jpwolfe31/8050A-Continuity-Tone-and-LED-Display/README.md

# 8050A-Continuity-Tone-and-LED-Display
Fluke 8050A Multimeter Modifications to Add Continuity Tone and LED Display

Added complete schematic and PCBs created with EasyEDA.  See the description for detailed build information made easier with the new PCBs.  Please let me know if you would like the EasyEDA project file for modifiicaitons.  Also, happy to answer any questions.



PCBs installed
