jpwolfe31/8050A-Continuity-Tone-and-LED-Display/Updated Schematic and PCBs/PCBs installed.JPG

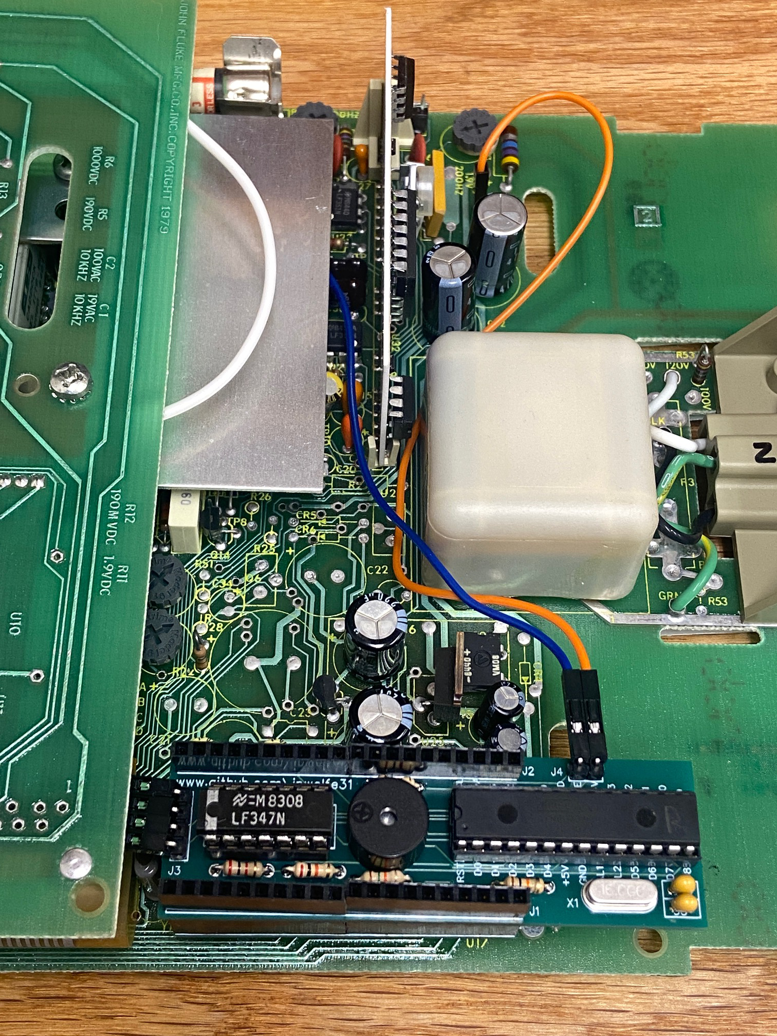
Updated Schematic and PCBs/PCBs installed.JPG
