jpwolfe31/8050A-Continuity-Tone-and-LED-Display/Updated Schematic and PCBs/8050A Carrier Board Schematic 6-12-2026.pdf

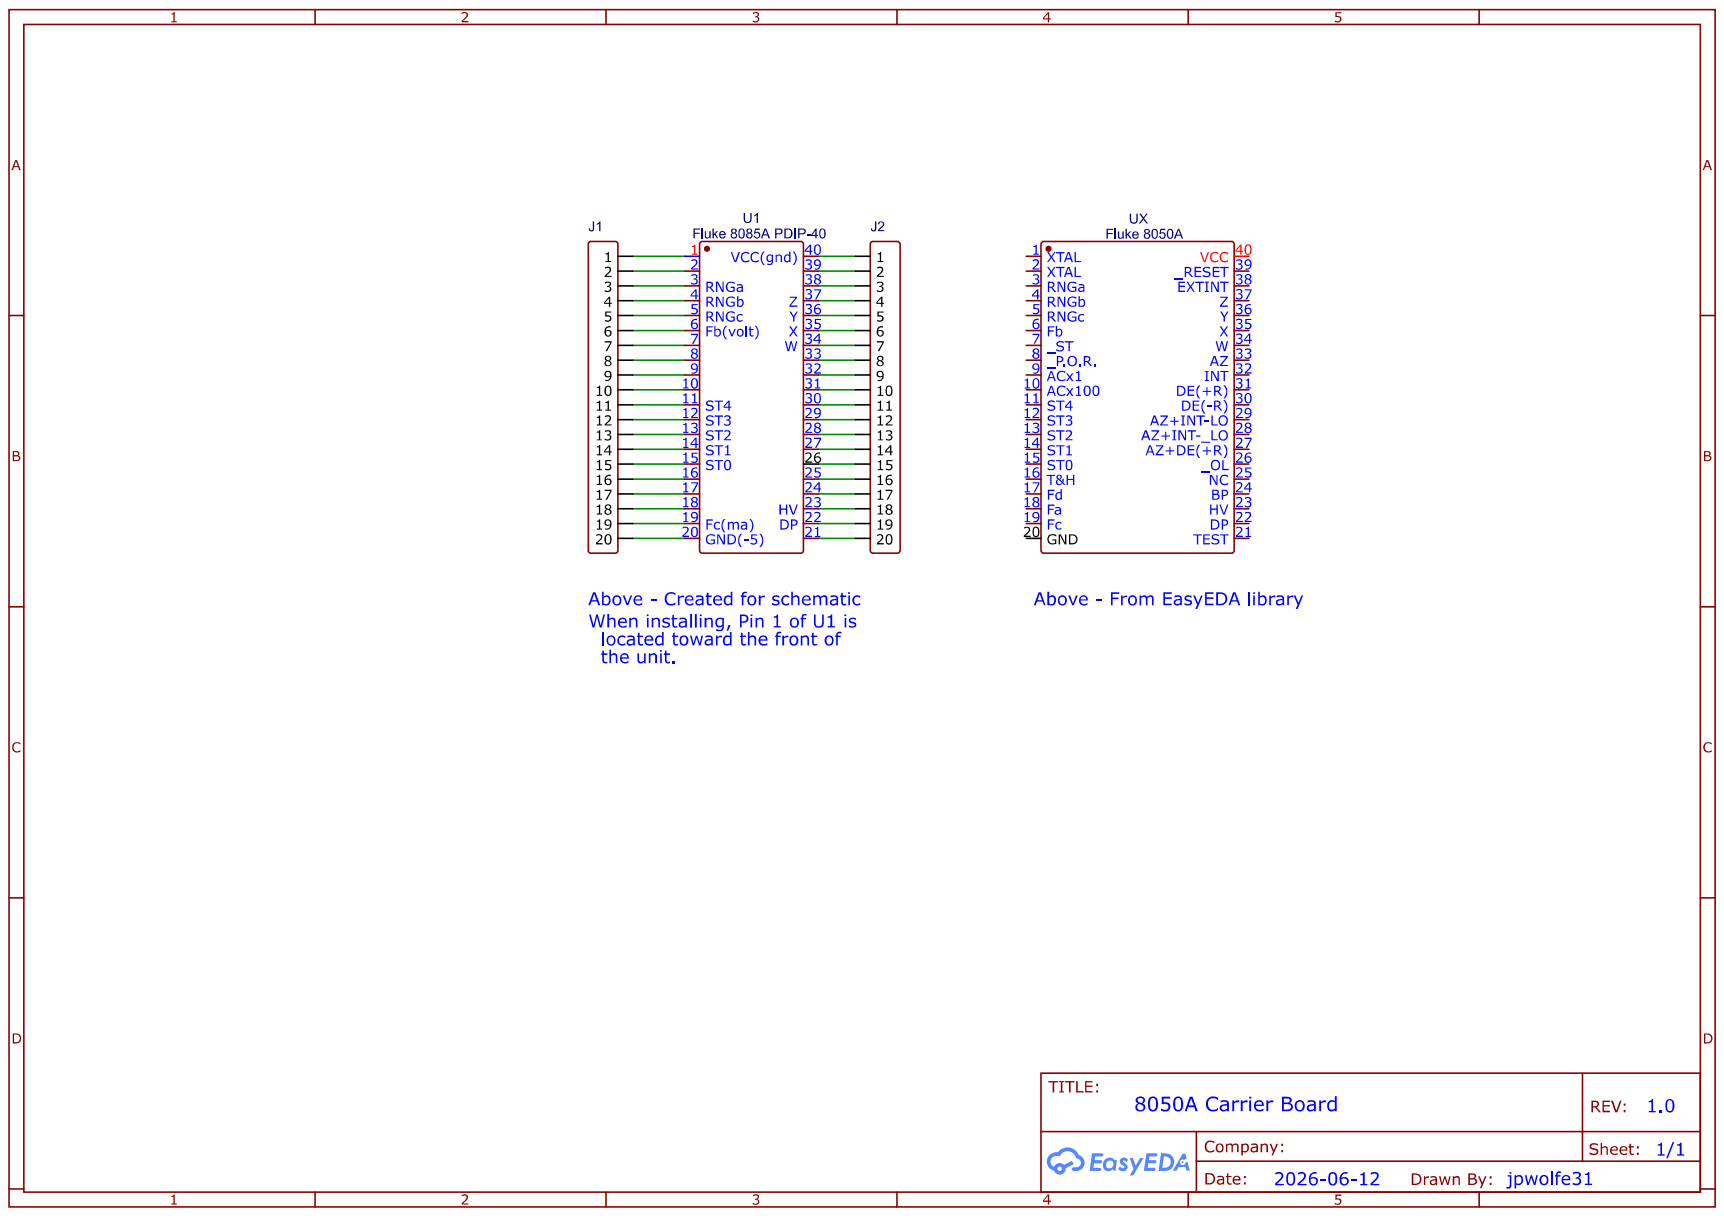
[picture p27: page 1]
