jpwolfe31/8050A-Continuity-Tone-and-LED-Display/Updated Schematic and PCBs/8050A LED and Continuity Schematic 6-12-2026.pdf

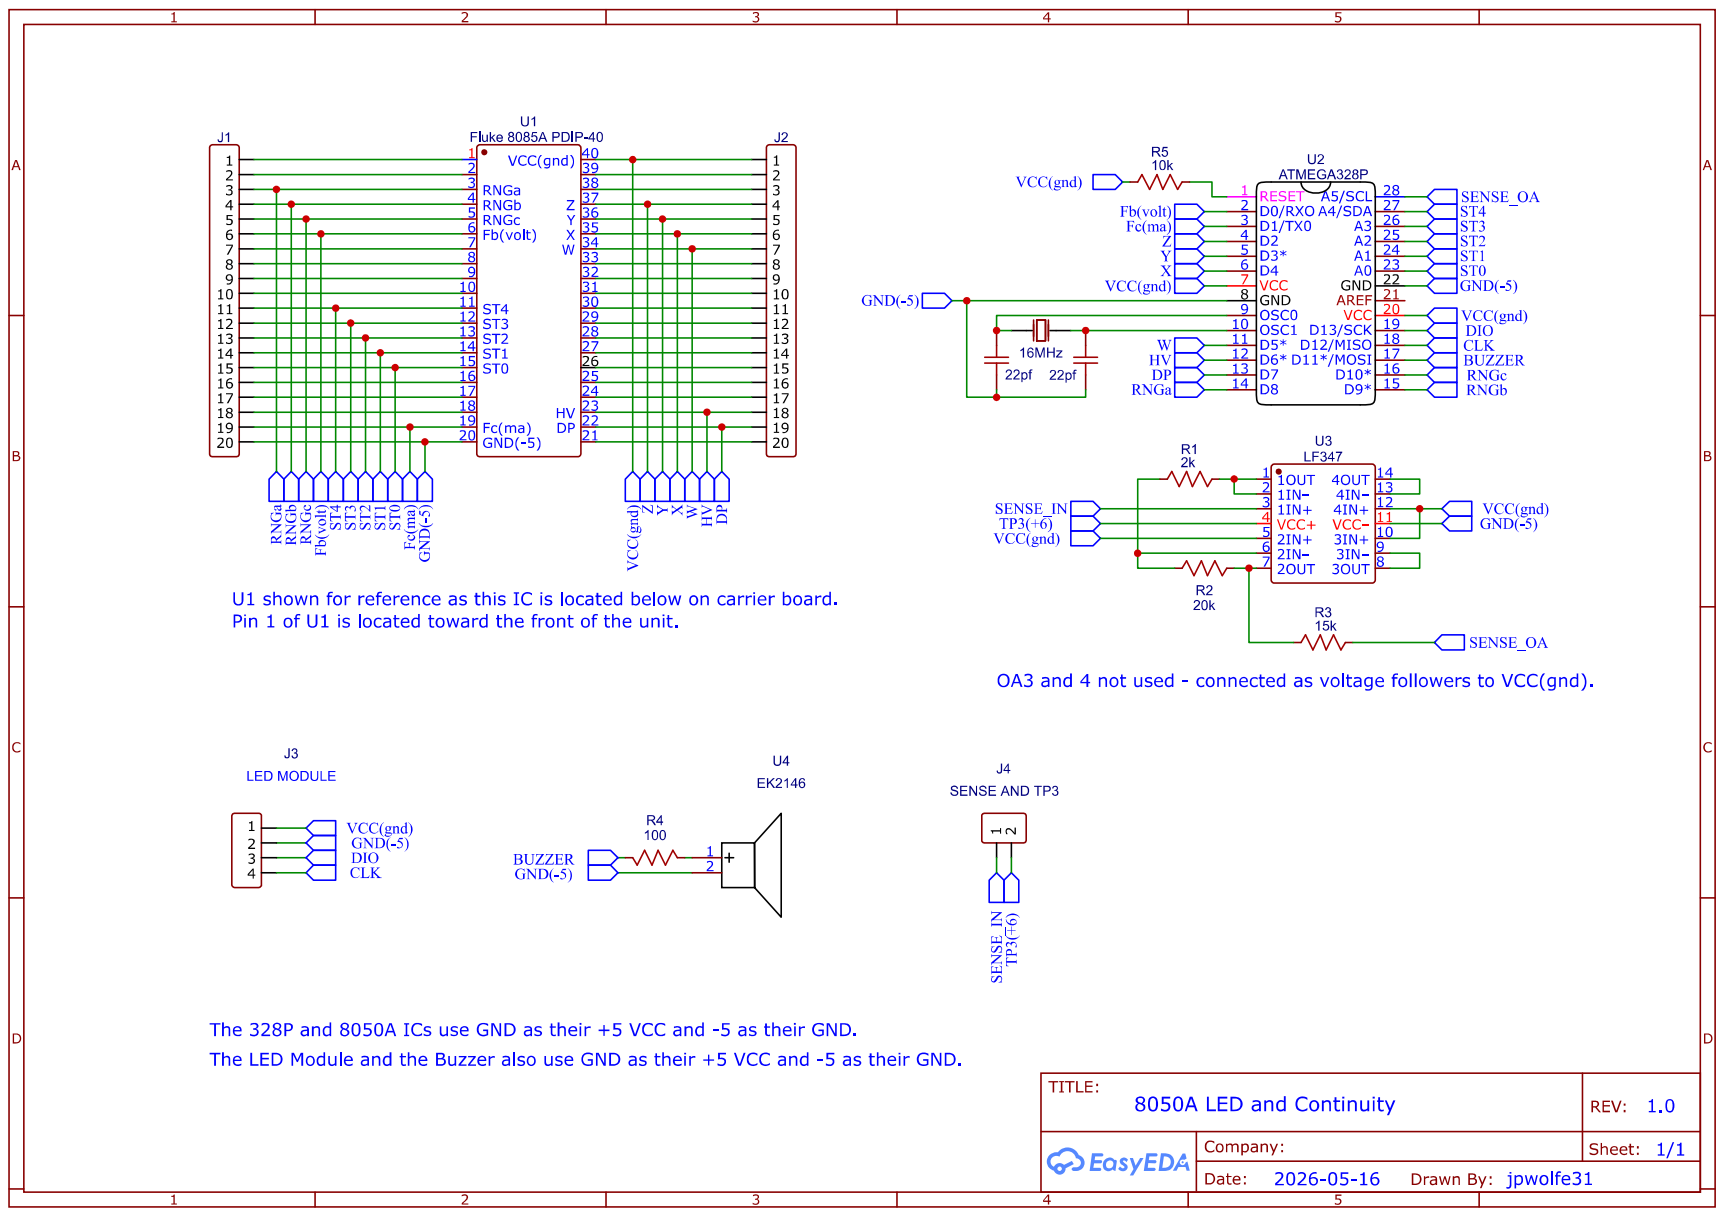
[picture p28: page 1]
